ryanjsims/word_clock/PartsList.xlsx

Design | Half | Cost full Total | $61.22 | Cost half Total | $53.21
Ref | Name | Quantity / Grid | Value | Footprint | Description | Vendor | Individual price | Subtotal | Qty Total | Total | URL | Percent of board price full | Percent of board half
J1, J3, | 24 Pin Socket | 2 | Conn_01x24 | Connector_PinSocket_2.54mm:PinSocket_1x24_P2.54mm_Vertical | Generic connector, single row, 01x24, script generated (kicad-library-utils/schlib/autogen/connector/) | Amazon | 0.35 | 0.7 | 2 | 0.7 | https://www.amazon.com/Haobase-2-54mm-Straight-Single-Headers/dp/B01DLX6RSQ/ref=pd_sim_23_1 | 1.143394305% | 1.315561352%
J2, | 5 Pin Header | 1 | Conn_01x05 | Connector_PinHeader_2.54mm:PinHeader_1x05_P2.54mm_Vertical | Generic connector, single row, 01x05, script generated (kicad-library-utils/schlib/autogen/connector/) | Amazon | 0.071125 | 0.071125 | 1 | 0.071125 | https://www.amazon.com/OdiySurveil-2-54mm-Straight-Single-Header/dp/B00UVPT5RI/ref=sr_1_18 | 0.1161770285% | 0.1336704303%
Q1, Q2, Q3, Q4, Q5, Q6, Q7, Q8, Q9, Q10, Q11, Q12, Q13, Q14, Q15, Q16, Q17, Q18, Q19, Q20, Q21, Q22, Q23, Q24, Q25, Q26, Q27, Q28, Q29, Q30, Q31, Q32, Q33, Q34, Q35, Q36, Q37, Q38, Q39, Q40, Q41, Q42, Q43, Q44, Q45, Q46, Q47, Q48, | NPN Low Current | 48 | 2N3904 | Package_TO_SOT_SMD:SOT-23_Handsoldering | 0.2A Ic, 40V Vce, Small Signal NPN Transistor, TO-92 | Digikey | 0.121 | 5.808 | 48 | 5.808 | https://www.digikey.com/product-detail/en/diodes-incorporated/MMBT3904-7-F/MMBT3904-FDICT-ND/815727 | 9.486905889% | 10.91540048%
R1, R4, R7, R10, R13, R16, R19, R22, R25, R28, R31, R34, R37, R40, R43, R46, | 100 Ohm Resistor | 16 | 100 Ohm Resistor | Resistor_THT:R_Axial_DIN0207_L6.3mm_D2.5mm_P10.16mm_Horizontal | Resistor US symbol | Digikey | 0.041 | 0.656 | 16 | 0.656 | https://www.digikey.com/product-detail/en/stackpole-electronics-inc/CF14JT100R/CF14JT100RCT-ND/1830327 | 1.071523806% | 1.232868925%
R2, R3, R5, R6, R8, R9, R11, R12, R14, R15, R17, R18, R20, R21, R23, R24, R26, R27, R29, R30, R32, R33, R35, R36, R38, R39, R41, R42, R44, R45, R47, R48, | 150 Ohm Resistor | 32 | 150 Ohm Resistor | Resistor_THT:R_Axial_DIN0207_L6.3mm_D2.5mm_P10.16mm_Horizontal | Resistor US symbol | Digikey | 0.0288 | 0.9216 | 32 | 0.9216 | https://www.digikey.com/product-detail/en/stackpole-electronics-inc/CF14JT150R/CF14JT150RCT-ND/1830603 | 1.505360273% | 1.732030489%
RN1, RN2, RN3, RN4, RN5, RN6, RN7, RN8, RN9, RN10, RN11, RN12, RN13, RN14, RN15, RN16, RN3 | 3 Resistor Pack | 17 | R_Pack03_SIP_10k | Resistor_THT:R_Array_SIP6 | 3 Resistor network, parallel topology, SIP package | Digikey | 0.328 | 5.576 | 17 | 5.576 | https://www.digikey.com/product-detail/en/bourns-inc/4606X-102-103LF/4606X-2-103LF-ND/1089007 | 9.107952348% | 10.47938586%
U1, U2, U3, U4, U5, U6, U7, U8, U9, U10, U11, U12, U13, U14, U15, U16, | ATTinyX5 | 16 | ATtiny85-20PU | Package_DIP:DIP-8_W7.62mm | 20MHz, 8kB Flash, 512B SRAM, 512B EEPROM, debugWIRE, DIP-8 | Digikey | 1.24 | 19.84 | 16 | 19.84 | https://www.digikey.com/product-detail/en/microchip-technology/ATTINY85-20PU/ATTINY85-20PU-ND/735469 | 32.40706144% | 37.28676747%
D1, D2, D3, D4, D5, D6, D7, D8, D9, D10, D11, D12, D13, D14, D15, D16, D17, D18, D19, D20, D21, D22, D23, D24, D25, D26, D27, D28, D29, D30, D31, D32, D33, D34, D35, D36, D37, D38, D39, D40, D41, D42, D43, D44, D45, D46, D47, D48, D49, D50, D51, D52, D53, D54, D55, D56, D57, D58, D59, D60, D61, D62, D63, D64, D65, D66, D67, D68, D69, D70, D71, D72, D73, D74, D75, D76, D77, D78, D79, D80, D81, D82, D83, D84, D85, D86, D87, D88, D89, D90, D91, D92, D93, D94, D95, D96, D97, D98, D99, D100, D101, D102, D103, D104, D105, D106, D107, D108, D109, D110, D111, D112, D113, D114, D115, D116, D117, D118, D119, D120, D121, D122, D123, D124, D125, D126, D127, D128, D129, D130, D131, D132, D133, D134, D135, D136, D137, D138, D139, D140, D141, D142, D143, D144, D145, D146, D147, D148, D149, D150, D151, D152, D153, D154, D155, D156, D157, D158, D159, D160, D161, D162, D163, D164, D165, D166, D167, D168, D169, D170, D171, D172, D173, D174, D175, D176, | RGB LED | 176 | LED_RGB | LED_SMD:LED_RGB_5050-6 | LED RGB 6 pins | Aliexpress - Slow | 0.0162 | 2.8512 | 200 | 3.24 | https://www.amazon.com/gp/product/B01CUGABPU/ref=oh_aui_detailpage_o03_s00?ie=UTF8&psc=1 | 5.292282211% | 6.089169688%
J1, | 12 Pin Header | 1 | Conn_01x12 | Connector_PinHeader_2.54mm:PinHeader_1x12_P2.54mm_Vertical | Generic connector, single row, 01x12, script generated (kicad-library-utils/schlib/autogen/connector/) | Amazon | 0.1707 | 0.1707 | 1 | 0.1707 | https://www.amazon.com/OdiySurveil-2-54mm-Straight-Single-Header/dp/B00UVPT5RI/ref=sr_1_18 | 0.2788248683% | 0.3208090326%
J3, J2, | 24 Pin Header | 2 | Conn_01x24 | Connector_PinHeader_2.54mm:PinHeader_1x24_P2.54mm_Vertical | Generic connector, single row, 01x24, script generated (kicad-library-utils/schlib/autogen/connector/) | Amazon | 0.3414 | 0.6828 | 2 | 0.6828 | https://www.amazon.com/OdiySurveil-2-54mm-Straight-Single-Header/dp/B00UVPT5RI/ref=sr_1_18 | 1.115299473% | 1.283236131%
Q1, Q7, Q2, Q8, Q3, Q9, Q4, Q10, Q5, Q11, Q6, | NPN Med Current | 11 | DNBT8105 | Package_TO_SOT_SMD:SOT-23_Handsoldering | 60V 1A NPN Transistor | Digikey | 0.309 | 3.399 | 11 | 3.399 | https://www.digikey.com/product-detail/en/diodes-incorporated/DNBT8105-7/DNBT8105DICT-ND/989959 | 5.55199606% | 6.387990052%
RN1, RN2 | 4 Resistor Pack | 2 | R_Pack04_SIP_10k | Resistor_THT:R_Array_SIP8 | 4 Resistor network, parallel topology, SIP package | Digikey | 0.58 | 1.16 | 2 | 1.16 | https://www.digikey.com/product-detail/en/bourns-inc/4608X-102-103LF/4608X-2-103LF-ND/1089107 | 1.894767705% | 2.180073098%
PCB1 | Grid PCB | 1 | PCB | grid.kicad_pcb | Printed Circuit Board | JLCPCB | 1.984 | 1.984 | 1 | 9.984 | https://jlcpcb.com | 16.30806963% | 18.76366363%
PCB2 | Controller PCB | 1 | PCB | controllers.kicad_pcb | Printed Circuit Board | JLCPCB | 1.012 | 1.012 | 1 | 9.012 | https://jlcpcb.com | 14.72038496% | 0%
PCB3 | Half Controller PCB | 2 | PCB | half_controllers.kicad_pcb | Printed Circuit Board | JLCPCB | 0.5 | 1 | 2 | 1 | https://jlcpcb.com | 0% | 1.879373361%
Items | Parts | Cost
Total per Grid | 327 | $44.82
Grids | 1
Total | 351 | $53.21
2N3904 Quantity | Price |  | 100 Ohm Qty | Price |  | DNBT8105 Qty | Price
1 | 0.13 |  | 1 | 0.1 |  | 1 | 0.38
10 | 0.121 |  | 10 | 0.041 |  | 10 | 0.309
100 | 0.0664 |  | 25 | 0.0292 |  | 100 | 0.1667
500 | 0.04152 |  | 50 | 0.0226 |  | 500 | 0.11138
1000 | 0.02884 |  | 100 | 0.0168 |  | 1000 | 0.07738
 |  |  | 250 | 0.01292
 |  |  | 500 | 0.01046
RN 3*10K Ohm Qty | Price |  | 1000 | 0.00784 |  | RN 4*10K Ohm Qty | Price
1 | 0.42 |  |  |  |  | 1 | 0.58
10 | 0.328 |  | 150 Ohm Qty | Price |  | 10 | 0.44
25 | 0.2504 |  | 1 | 0.1 |  | 25 | 0.336
50 | 0.1872 |  | 10 | 0.04 |  | 50 | 0.2508
100 | 0.1401 |  | 25 | 0.0288 |  | 100 | 0.1877
250 | 0.11892 |  | 50 | 0.022 |  | 250 | 0.1594
500 | 0.10246 |  | 100 | 0.0162 |  | 500 | 0.13734
1000 | 0.07896 |  | 250 | 0.01236 |  | 1000 | 0.10584
5000 | 0.06721 |  | 500 | 0.0099 |  | 5000 | 0.09009
 |  |  | 1000 | 0.00729
ATTiny85 Quantity | Price
1 | 1.24 |  | https://www.aliexpress.com/item/100pcs-Ultra-Bright-Red-Green-Blue-SMT-SMD-LED-RGB-5050-LED-DIODE-Chip-Light-Emitting/32340120687.html
25 | 1.1332 |  | Aliexpress RGB LED Qty | Price
100 | 1.03 |  | 100 | 0.0398
 |  |  | 1000 | 0.0239
ATTiny25 Quantity | Price
1 | 1.11 |  | https://www.aliexpress.com/item/100-pcs-5050-RGB-SMD-LED-RED-BLUE-GREEN-SMT-LED-PLCC-6-3-CHIPS-Light/32598851549.html
25 | 1.0196 |  | Aliexpress - Slow RGB LED Qty | Price
100 | 0.9167 |  | 100 | 0.0162
 |  |  | https://www.amazon.com/gp/product/B01CUGABPU/ref=oh_aui_detailpage_o03_s00?ie=UTF8&psc=1
 |  |  | Amazon RGB LED Qty | Price
 |  |  | 100 | 0.0738
