ryanjsims/word_clock/clock_face.dxf

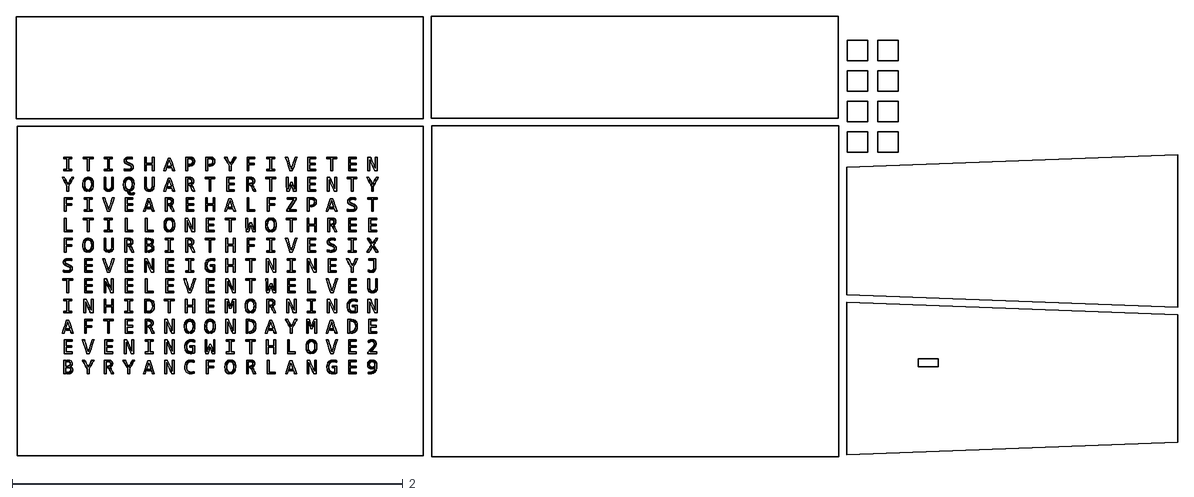
[picture p1: CAD file, 2018-10-16]
clock_face.dxf
5.94 x 2.25
