ryanjsims/word_clock/clock_model.FCStd

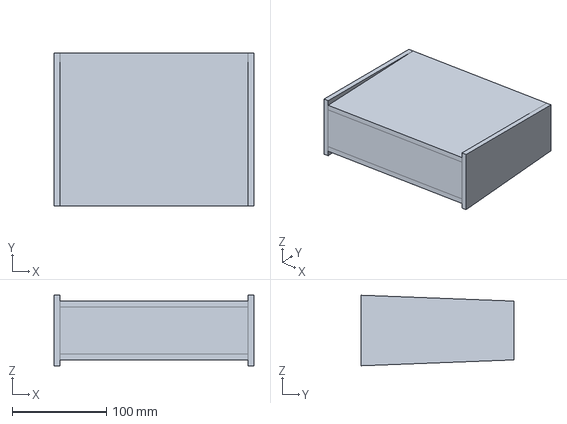
[picture p2: CAD file, 2018-10-16]
clock_model.FCStd
212.5 x 162.5 x 75.0 mm
