ryanjsims/word_clock/(list of files, drawings)

Other design files:
led_grid.fzz
