ryanjsims/word_clock/LED_grid_no_controllers/LED_grid_no_controllers.kicad_pcb

## KiCad design LED_grid_no_controllers/LED_grid_no_controllers.kicad_pcb (2018-12-21)

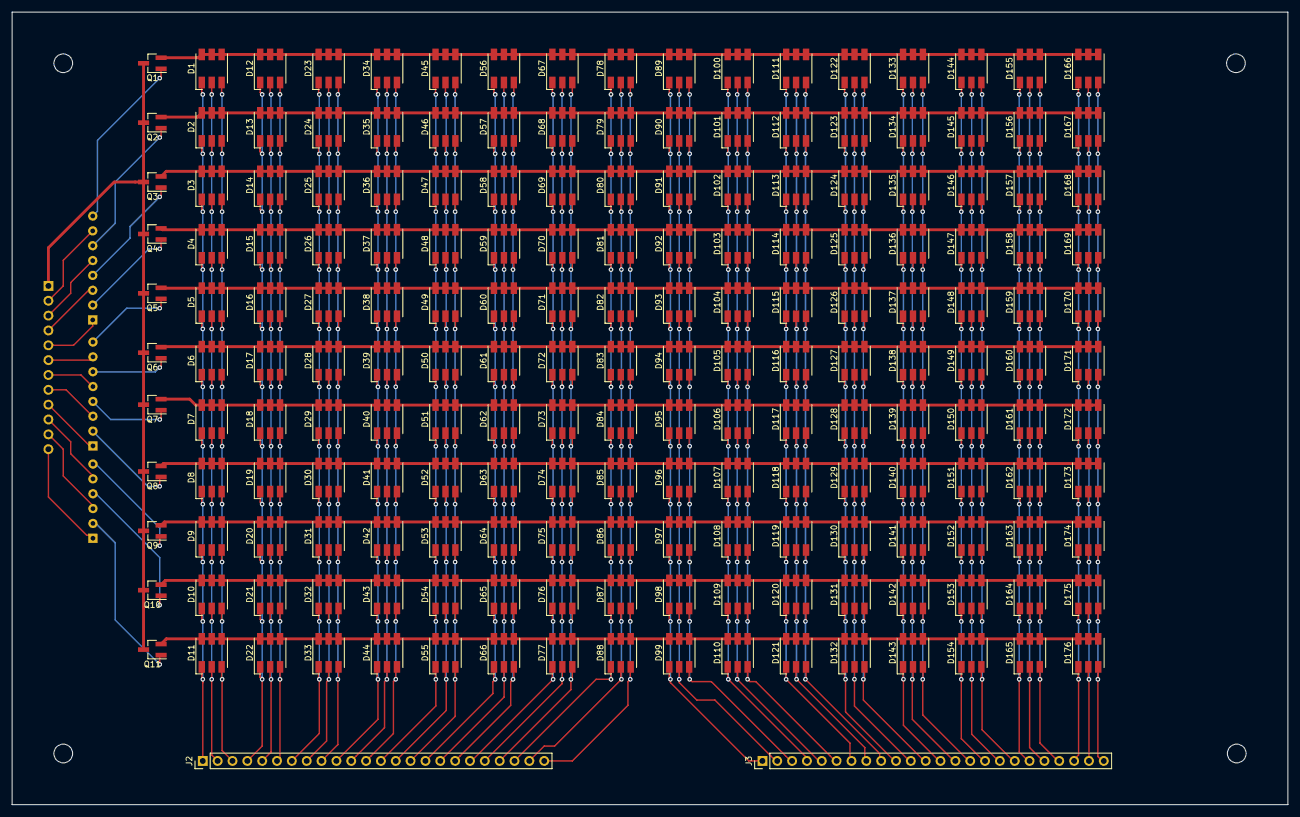
[picture p3: board LED_grid_no_controllers.kicad_pcb from above]

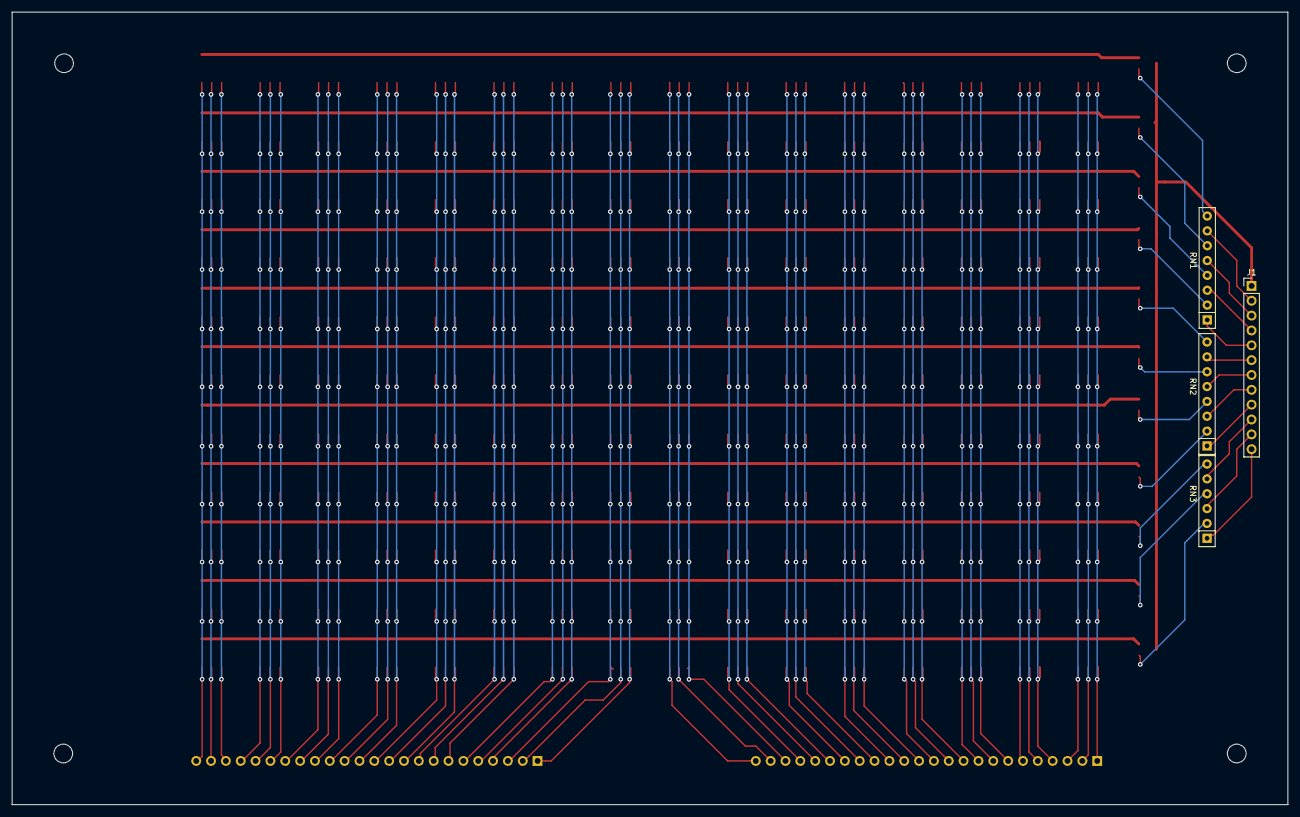
[picture p4: board LED_grid_no_controllers.kicad_pcb from below]

Board: 2 copper layers, 218.3 x 135.6 mm, 193 parts (4 on the bottom side), 82 nets.

Parts:
D1, D2, D3, D4, D5, D6, D7, D8, D9, D10, D11, D12, D13, D14, D15, D16, D17, D18, D19, D20, D21, D22, D23, D24, D25, D26, D27, D28, D29, D30, D31, D32, D33, D34, D35, D36, D37, D38, D39, D40, D41, D42, D43, D44, D45, D46, D47, D48, D49, D50, D51, D52, D53, D54, D55, D56, D57, D58, D59, D60, D61, D62, D63, D64, D65, D66, D67, D68, D69, D70, D71, D72, D73, D74, D75, D76, D77, D78, D79, D80, D81, D82, D83, D84, D85, D86, D87, D88, D89, D90, D91, D92, D93, D94, D95, D96, D97, D98, D99, D100, D101, D102, D103, D104, D105, D106, D107, D108, D109, D110, D111, D112, D113, D114, D115, D116, D117, D118, D119, D120, D121, D122, D123, D124, D125, D126, D127, D128, D129, D130, D131, D132, D133, D134, D135, D136, D137, D138, D139, D140, D141, D142, D143, D144, D145, D146, D147, D148, D149, D150, D151, D152, D153, D154, D155, D156, D157, D158, D159, D160, D161, D162, D163, D164, D165, D166, D167, D168, D169, D170, D171, D172, D173, D174, D175, D176: LED_RGB; LED_RGB_5050-6
J1: Conn_01x12; PinHeader_1x12_P2.54mm_Vertical
J2, J3: Conn_01x24; PinHeader_1x24_P2.54mm_Vertical
Q1, Q2, Q3, Q4, Q5, Q6, Q7, Q8, Q9, Q10, Q11: DNBT8105; SOT-23_Handsoldering
RN1, RN2: R_Pack04_SIP_10k; R_Array_SIP8
RN3: R_Pack03_SIP_10k; R_Array_SIP6

Connections:
+5V: J1.1, Q1.3, Q2.3, Q3.3, Q4.3, Q5.3, Q6.3, Q7.3, Q8.3, Q9.3, Q10.3, Q11.3
/B0: D1.3, D2.3, D3.3, D4.3, D5.3, D6.3, D7.3, D8.3, D9.3, D10.3, D11.3, J2.3
/B1: D12.3, D13.3, D14.3, D15.3, D16.3, D17.3, D18.3, D19.3, D20.3, D21.3, D22.3, J2.6
/B2: D23.3, D24.3, D25.3, D26.3, D27.3, D28.3, D29.3, D30.3, D31.3, D32.3, D33.3, J2.9
/B3: D34.3, D35.3, D36.3, D37.3, D38.3, D39.3, D40.3, D41.3, D42.3, D43.3, D44.3, J2.12
/B4: D45.3, D46.3, D47.3, D48.3, D49.3, D50.3, D51.3, D52.3, D53.3, D54.3, D55.3, J2.15
/B5: D56.3, D57.3, D58.3, D59.3, D60.3, D61.3, D62.3, D63.3, D64.3, D65.3, D66.3, J2.18
/B6: D67.3, D68.3, D69.3, D70.3, D71.3, D72.3, D73.3, D74.3, D75.3, D76.3, D77.3, J2.21
/B7: D78.3, D79.3, D80.3, D81.3, D82.3, D83.3, D84.3, D85.3, D86.3, D87.3, D88.3, J2.24
/B8: D89.3, D90.3, D91.3, D92.3, D93.3, D94.3, D95.3, D96.3, D97.3, D98.3, D99.3, J3.3
/B9: D100.3, D101.3, D102.3, D103.3, D104.3, D105.3, D106.3, D107.3, D108.3, D109.3, D110.3, J3.6
/B10: D111.3, D112.3, D113.3, D114.3, D115.3, D116.3, D117.3, D118.3, D119.3, D120.3, D121.3, J3.9
/B11: D122.3, D123.3, D124.3, D125.3, D126.3, D127.3, D128.3, D129.3, D130.3, D131.3, D132.3, J3.12
/B12: D133.3, D134.3, D135.3, D136.3, D137.3, D138.3, D139.3, D140.3, D141.3, D142.3, D143.3, J3.15
/B13: D144.3, D145.3, D146.3, D147.3, D148.3, D149.3, D150.3, D151.3, D152.3, D153.3, D154.3, J3.18
/B14: D155.3, D156.3, D157.3, D158.3, D159.3, D160.3, D161.3, D162.3, D163.3, D164.3, D165.3, J3.21
/B15: D166.3, D167.3, D168.3, D169.3, D170.3, D171.3, D172.3, D173.3, D174.3, D175.3, D176.3, J3.24
/G0: D1.2, D2.2, D3.2, D4.2, D5.2, D6.2, D7.2, D8.2, D9.2, D10.2, D11.2, J2.2
/G1: D12.2, D13.2, D14.2, D15.2, D16.2, D17.2, D18.2, D19.2, D20.2, D21.2, D22.2, J2.5
/G2: D23.2, D24.2, D25.2, D26.2, D27.2, D28.2, D29.2, D30.2, D31.2, D32.2, D33.2, J2.8
/G3: D34.2, D35.2, D36.2, D37.2, D38.2, D39.2, D40.2, D41.2, D42.2, D43.2, D44.2, J2.11
/G4: D45.2, D46.2, D47.2, D48.2, D49.2, D50.2, D51.2, D52.2, D53.2, D54.2, D55.2, J2.14
/G5: D56.2, D57.2, D58.2, D59.2, D60.2, D61.2, D62.2, D63.2, D64.2, D65.2, D66.2, J2.17
/G6: D67.2, D68.2, D69.2, D70.2, D71.2, D72.2, D73.2, D74.2, D75.2, D76.2, D77.2, J2.20
/G7: D78.2, D79.2, D80.2, D81.2, D82.2, D83.2, D84.2, D85.2, D86.2, D87.2, D88.2, J2.23
/G8: D89.2, D90.2, D91.2, D92.2, D93.2, D94.2, D95.2, D96.2, D97.2, D98.2, D99.2, J3.2
/G9: D100.2, D101.2, D102.2, D103.2, D104.2, D105.2, D106.2, D107.2, D108.2, D109.2, D110.2, J3.5
/G10: D111.2, D112.2, D113.2, D114.2, D115.2, D116.2, D117.2, D118.2, D119.2, D120.2, D121.2, J3.8
/G11: D122.2, D123.2, D124.2, D125.2, D126.2, D127.2, D128.2, D129.2, D130.2, D131.2, D132.2, J3.11
/G12: D133.2, D134.2, D135.2, D136.2, D137.2, D138.2, D139.2, D140.2, D141.2, D142.2, D143.2, J3.14
/G13: D144.2, D145.2, D146.2, D147.2, D148.2, D149.2, D150.2, D151.2, D152.2, D153.2, D154.2, J3.17
/G14: D155.2, D156.2, D157.2, D158.2, D159.2, D160.2, D161.2, D162.2, D163.2, D164.2, D165.2, J3.20
/G15: D166.2, D167.2, D168.2, D169.2, D170.2, D171.2, D172.2, D173.2, D174.2, D175.2, D176.2, J3.23
/R0: D1.1, D2.1, D3.1, D4.1, D5.1, D6.1, D7.1, D8.1, D9.1, D10.1, D11.1, J2.1
/R1: D12.1, D13.1, D14.1, D15.1, D16.1, D17.1, D18.1, D19.1, D20.1, D21.1, D22.1, J2.4
/R2: D23.1, D24.1, D25.1, D26.1, D27.1, D28.1, D29.1, D30.1, D31.1, D32.1, D33.1, J2.7
/R3: D34.1, D35.1, D36.1, D37.1, D38.1, D39.1, D40.1, D41.1, D42.1, D43.1, D44.1, J2.10
/R4: D45.1, D46.1, D47.1, D48.1, D49.1, D50.1, D51.1, D52.1, D53.1, D54.1, D55.1, J2.13
/R5: D56.1, D57.1, D58.1, D59.1, D60.1, D61.1, D62.1, D63.1, D64.1, D65.1, D66.1, J2.16
/R6: D67.1, D68.1, D69.1, D70.1, D71.1, D72.1, D73.1, D74.1, D75.1, D76.1, D77.1, J2.19
/R7: D78.1, D79.1, D80.1, D81.1, D82.1, D83.1, D84.1, D85.1, D86.1, D87.1, D88.1, J2.22
/R8: D89.1, D90.1, D91.1, D92.1, D93.1, D94.1, D95.1, D96.1, D97.1, D98.1, D99.1, J3.1
/R9: D100.1, D101.1, D102.1, D103.1, D104.1, D105.1, D106.1, D107.1, D108.1, D109.1, D110.1, J3.4
/R10: D111.1, D112.1, D113.1, D114.1, D115.1, D116.1, D117.1, D118.1, D119.1, D120.1, D121.1, J3.7
/R11: D122.1, D123.1, D124.1, D125.1, D126.1, D127.1, D128.1, D129.1, D130.1, D131.1, D132.1, J3.10
/R12: D133.1, D134.1, D135.1, D136.1, D137.1, D138.1, D139.1, D140.1, D141.1, D142.1, D143.1, J3.13
/R13: D144.1, D145.1, D146.1, D147.1, D148.1, D149.1, D150.1, D151.1, D152.1, D153.1, D154.1, J3.16
/R14: D155.1, D156.1, D157.1, D158.1, D159.1, D160.1, D161.1, D162.1, D163.1, D164.1, D165.1, J3.19
/R15: D166.1, D167.1, D168.1, D169.1, D170.1, D171.1, D172.1, D173.1, D174.1, D175.1, D176.1, J3.22
/ROW0: D1.4, D1.5, D1.6, D12.4, D12.5, D12.6, D23.4, D23.5, D23.6, D34.4, D34.5, D34.6, D45.4, D45.5, D45.6, D56.4, D56.5, D56.6, D67.4, D67.5, D67.6, D78.4, D78.5, D78.6, D89.4, D89.5, D89.6, D100.4, D100.5, D100.6, D111.4, D111.5, D111.6, D122.4, D122.5, D122.6, D133.4, D133.5, D133.6, D144.4, D144.5, D144.6, D155.4, D155.5, D155.6, D166.4, D166.5, D166.6, Q1.2
/ROW1: D2.4, D2.5, D2.6, D13.4, D13.5, D13.6, D24.4, D24.5, D24.6, D35.4, D35.5, D35.6, D46.4, D46.5, D46.6, D57.4, D57.5, D57.6, D68.4, D68.5, D68.6, D79.4, D79.5, D79.6, D90.4, D90.5, D90.6, D101.4, D101.5, D101.6, D112.4, D112.5, D112.6, D123.4, D123.5, D123.6, D134.4, D134.5, D134.6, D145.4, D145.5, D145.6, D156.4, D156.5, D156.6, D167.4, D167.5, D167.6, Q2.2
/ROW2: D3.4, D3.5, D3.6, D14.4, D14.5, D14.6, D25.4, D25.5, D25.6, D36.4, D36.5, D36.6, D47.4, D47.5, D47.6, D58.4, D58.5, D58.6, D69.4, D69.5, D69.6, D80.4, D80.5, D80.6, D91.4, D91.5, D91.6, D102.4, D102.5, D102.6, D113.4, D113.5, D113.6, D124.4, D124.5, D124.6, D135.4, D135.5, D135.6, D146.4, D146.5, D146.6, D157.4, D157.5, D157.6, D168.4, D168.5, D168.6, Q3.2
/ROW3: D4.4, D4.5, D4.6, D15.4, D15.5, D15.6, D26.4, D26.5, D26.6, D37.4, D37.5, D37.6, D48.4, D48.5, D48.6, D59.4, D59.5, D59.6, D70.4, D70.5, D70.6, D81.4, D81.5, D81.6, D92.4, D92.5, D92.6, D103.4, D103.5, D103.6, D114.4, D114.5, D114.6, D125.4, D125.5, D125.6, D136.4, D136.5, D136.6, D147.4, D147.5, D147.6, D158.4, D158.5, D158.6, D169.4, D169.5, D169.6, Q4.2
/ROW4: D5.4, D5.5, D5.6, D16.4, D16.5, D16.6, D27.4, D27.5, D27.6, D38.4, D38.5, D38.6, D49.4, D49.5, D49.6, D60.4, D60.5, D60.6, D71.4, D71.5, D71.6, D82.4, D82.5, D82.6, D93.4, D93.5, D93.6, D104.4, D104.5, D104.6, D115.4, D115.5, D115.6, D126.4, D126.5, D126.6, D137.4, D137.5, D137.6, D148.4, D148.5, D148.6, D159.4, D159.5, D159.6, D170.4, D170.5, D170.6, Q5.2
/ROW5: D6.4, D6.5, D6.6, D17.4, D17.5, D17.6, D28.4, D28.5, D28.6, D39.4, D39.5, D39.6, D50.4, D50.5, D50.6, D61.4, D61.5, D61.6, D72.4, D72.5, D72.6, D83.4, D83.5, D83.6, D94.4, D94.5, D94.6, D105.4, D105.5, D105.6, D116.4, D116.5, D116.6, D127.4, D127.5, D127.6, D138.4, D138.5, D138.6, D149.4, D149.5, D149.6, D160.4, D160.5, D160.6, D171.4, D171.5, D171.6, Q6.2
/ROW6: D7.4, D7.5, D7.6, D18.4, D18.5, D18.6, D29.4, D29.5, D29.6, D40.4, D40.5, D40.6, D51.4, D51.5, D51.6, D62.4, D62.5, D62.6, D73.4, D73.5, D73.6, D84.4, D84.5, D84.6, D95.4, D95.5, D95.6, D106.4, D106.5, D106.6, D117.4, D117.5, D117.6, D128.4, D128.5, D128.6, D139.4, D139.5, D139.6, D150.4, D150.5, D150.6, D161.4, D161.5, D161.6, D172.4, D172.5, D172.6, Q7.2
/ROW7: D8.4, D8.5, D8.6, D19.4, D19.5, D19.6, D30.4, D30.5, D30.6, D41.4, D41.5, D41.6, D52.4, D52.5, D52.6, D63.4, D63.5, D63.6, D74.4, D74.5, D74.6, D85.4, D85.5, D85.6, D96.4, D96.5, D96.6, D107.4, D107.5, D107.6, D118.4, D118.5, D118.6, D129.4, D129.5, D129.6, D140.4, D140.5, D140.6, D151.4, D151.5, D151.6, D162.4, D162.5, D162.6, D173.4, D173.5, D173.6, Q8.2
/ROW8: D9.4, D9.5, D9.6, D20.4, D20.5, D20.6, D31.4, D31.5, D31.6, D42.4, D42.5, D42.6, D53.4, D53.5, D53.6, D64.4, D64.5, D64.6, D75.4, D75.5, D75.6, D86.4, D86.5, D86.6, D97.4, D97.5, D97.6, D108.4, D108.5, D108.6, D119.4, D119.5, D119.6, D130.4, D130.5, D130.6, D141.4, D141.5, D141.6, D152.4, D152.5, D152.6, D163.4, D163.5, D163.6, D174.4, D174.5, D174.6, Q9.2
/ROW9: D10.4, D10.5, D10.6, D21.4, D21.5, D21.6, D32.4, D32.5, D32.6, D43.4, D43.5, D43.6, D54.4, D54.5, D54.6, D65.4, D65.5, D65.6, D76.4, D76.5, D76.6, D87.4, D87.5, D87.6, D98.4, D98.5, D98.6, D109.4, D109.5, D109.6, D120.4, D120.5, D120.6, D131.4, D131.5, D131.6, D142.4, D142.5, D142.6, D153.4, D153.5, D153.6, D164.4, D164.5, D164.6, D175.4, D175.5, D175.6, Q10.2
/ROW10: D11.4, D11.5, D11.6, D22.4, D22.5, D22.6, D33.4, D33.5, D33.6, D44.4, D44.5, D44.6, D55.4, D55.5, D55.6, D66.4, D66.5, D66.6, D77.4, D77.5, D77.6, D88.4, D88.5, D88.6, D99.4, D99.5, D99.6, D110.4, D110.5, D110.6, D121.4, D121.5, D121.6, D132.4, D132.5, D132.6, D143.4, D143.5, D143.6, D154.4, D154.5, D154.6, D165.4, D165.5, D165.6, D176.4, D176.5, D176.6, Q11.2
/ROW_IN_0: J1.2, RN1.7
/ROW_IN_1: J1.3, RN1.5
/ROW_IN_2: J1.4, RN1.3
/ROW_IN_3: J1.5, RN1.1
/ROW_IN_4: J1.6, RN2.7
/ROW_IN_5: J1.7, RN2.5
/ROW_IN_6: J1.8, RN2.3
/ROW_IN_7: J1.9, RN2.1
/ROW_IN_8: J1.10, RN3.5
/ROW_IN_9: J1.11, RN3.3
/ROW_IN_10: J1.12, RN3.1
/ROW_SEL_0: Q1.1, RN1.8
/ROW_SEL_1: Q2.1, RN1.6
/ROW_SEL_2: Q3.1, RN1.4
/ROW_SEL_3: Q4.1, RN1.2
/ROW_SEL_4: Q5.1, RN2.8
/ROW_SEL_5: Q6.1, RN2.6
/ROW_SEL_6: Q7.1, RN2.4
/ROW_SEL_7: Q8.1, RN2.2
/ROW_SEL_8: Q9.1, RN3.6
/ROW_SEL_9: Q10.1, RN3.4
/ROW_SEL_10: Q11.1, RN3.2
