ryanjsims/word_clock/LED_grid_controllers/LED_grid_half_controllers.kicad_pcb

## KiCad design LED_grid_controllers/LED_grid_half_controllers.kicad_pcb (2018-12-21)

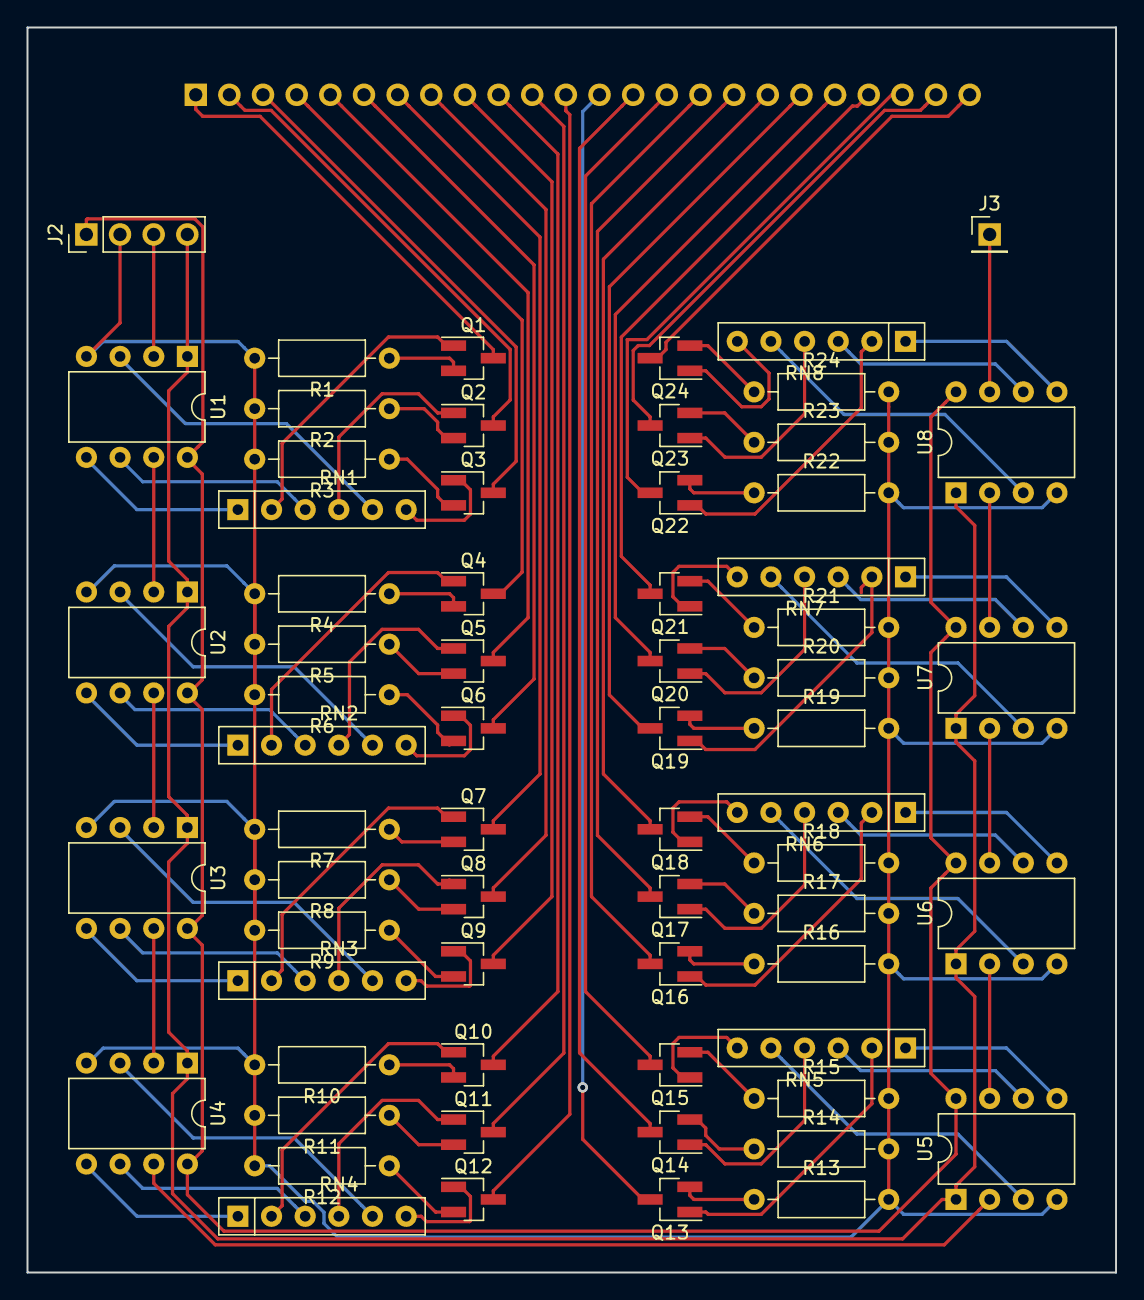
[picture p5: board LED_grid_half_controllers.kicad_pcb from above]

Board: 2 copper layers, 82.2 x 94.0 mm, 67 parts (1 on the bottom side), 108 nets.

Parts:
J1: Conn_01x24; PinSocket_1x24_P2.54mm_Vertical
J2: Conn_01x04; PinHeader_1x04_P2.54mm_Vertical
J3: Conn_01x01; PinHeader_1x01_P2.54mm_Vertical
Q1, Q2, Q3, Q4, Q5, Q6, Q7, Q8, Q9, Q10, Q11, Q12, Q13, Q14, Q15, Q16, Q17, Q18, Q19, Q20, Q21, Q22, Q23, Q24: 2N3904_SOT-23; SOT-23_Handsoldering
R1, R4, R7, R10, R13, R16, R19, R22: 100; R_Axial_DIN0207_L6.3mm_D2.5mm_P10.16mm_Horizontal
R2, R3, R5, R6, R8, R9, R11, R12, R14, R15, R17, R18, R20, R21, R23, R24: 150; R_Axial_DIN0207_L6.3mm_D2.5mm_P10.16mm_Horizontal
RN1, RN2, RN3, RN4, RN5, RN6, RN7, RN8: R_Pack03_SIP_10k; R_Array_SIP6
U1, U2, U3, U4, U5, U6, U7, U8: ATtiny85-20PU; DIP-8_W7.62mm

Connections:
+5V: J2.1, U1.8, U2.8, U3.8, U4.8, U5.8, U6.8, U7.8, U8.8
/B0: J1.3, Q3.3
/B1: J1.6, Q6.3
/B2: J1.9, Q9.3
/B3: J1.12, Q12.3
/B4: J1.15, Q15.3
/B5: J1.18, Q18.3
/B6: J1.21, Q21.3
/B7: J1.24, Q24.3
/Controller0/B_PWM: RN1.5, U1.3
/Controller0/B_RES_OUT: Q3.1, RN1.6
/Controller0/G_PWM: RN1.3, U1.6
/Controller0/G_RES_OUT: Q2.1, RN1.4
/Controller0/R_PWM: RN1.1, U1.5
/Controller0/R_RES_OUT: Q1.1, RN1.2
/Controller1/B_PWM: RN2.5, U2.3
/Controller1/B_RES_OUT: Q6.1, RN2.6
/Controller1/DIN: U1.7, U2.2
/Controller1/G_PWM: RN2.3, U2.6
/Controller1/G_RES_OUT: Q5.1, RN2.4
/Controller1/R_PWM: RN2.1, U2.5
/Controller1/R_RES_OUT: Q4.1, RN2.2
/Controller2/B_PWM: RN3.5, U3.3
/Controller2/B_RES_OUT: Q9.1, RN3.6
/Controller2/DIN: U2.7, U3.2
/Controller2/G_PWM: RN3.3, U3.6
/Controller2/G_RES_OUT: Q8.1, RN3.4
/Controller2/R_PWM: RN3.1, U3.5
/Controller2/R_RES_OUT: Q7.1, RN3.2
/Controller3/B_PWM: RN4.5, U4.3
/Controller3/B_RES_OUT: Q12.1, RN4.6
/Controller3/DIN: U3.7, U4.2
/Controller3/G_PWM: RN4.3, U4.6
/Controller3/G_RES_OUT: Q11.1, RN4.4
/Controller3/R_PWM: RN4.1, U4.5
/Controller3/R_RES_OUT: Q10.1, RN4.2
/Controller4/B_PWM: RN5.5, U5.3
/Controller4/B_RES_OUT: Q15.1, RN5.6
/Controller4/G_PWM: RN5.3, U5.6
/Controller4/G_RES_OUT: Q14.1, RN5.4
/Controller4/R_PWM: RN5.1, U5.5
/Controller4/R_RES_OUT: Q13.1, RN5.2
/Controller5/B_PWM: RN6.5, U6.3
/Controller5/B_RES_OUT: Q18.1, RN6.6
/Controller5/DIN: U5.7, U6.2
/Controller5/G_PWM: RN6.3, U6.6
/Controller5/G_RES_OUT: Q17.1, RN6.4
/Controller5/R_PWM: RN6.1, U6.5
/Controller5/R_RES_OUT: Q16.1, RN6.2
/Controller6/B_PWM: RN7.5, U7.3
/Controller6/B_RES_OUT: Q21.1, RN7.6
/Controller6/DIN: U6.7, U7.2
/Controller6/G_PWM: RN7.3, U7.6
/Controller6/G_RES_OUT: Q20.1, RN7.4
/Controller6/R_PWM: RN7.1, U7.5
/Controller6/R_RES_OUT: Q19.1, RN7.2
/Controller7/B_PWM: RN8.5, U8.3
/Controller7/B_RES_OUT: Q24.1, RN8.6
/Controller7/DIN: U7.7, U8.2
/Controller7/G_PWM: RN8.3, U8.6
/Controller7/G_RES_OUT: Q23.1, RN8.4
/Controller7/R_PWM: RN8.1, U8.5
/Controller7/R_RES_OUT: Q22.1, RN8.2
/DCLK: J2.4, U1.1, U2.1, U3.1, U4.1, U5.1, U6.1, U7.1, U8.1
/DIN: J2.3, U1.2
/DOUT: J3.1, U8.7
/DOUT3: U4.7, U5.2
/G0: J1.2, Q2.3
/G1: J1.5, Q5.3
/G2: J1.8, Q8.3
/G3: J1.11, Q11.3
/G4: J1.14, Q14.3
/G5: J1.17, Q17.3
/G6: J1.20, Q20.3
/G7: J1.23, Q23.3
/R0: J1.1, Q1.3
/R1: J1.4, Q4.3
/R2: J1.7, Q7.3
/R3: J1.10, Q10.3
/R4: J1.13, Q13.3
/R5: J1.16, Q16.3
/R6: J1.19, Q19.3
/R7: J1.22, Q22.3
GND: J2.2, R1.2, R2.2, R3.2, R4.2, R5.2, R6.2, R7.2, R8.2, R9.2, R10.2, R11.2, R12.2, R13.2, R14.2, R15.2, R16.2, R17.2, R18.2, R19.2, R20.2, R21.2, R22.2, R23.2, R24.2, U1.4, U2.4, U3.4, U4.4, U5.4, U6.4, U7.4, U8.4
unnamed: Q1.2, R1.1
unnamed: Q2.2, R2.1
unnamed: Q3.2, R3.1
unnamed: Q4.2, R4.1
unnamed: Q5.2, R5.1
unnamed: Q6.2, R6.1
unnamed: Q7.2, R7.1
unnamed: Q8.2, R8.1
unnamed: Q9.2, R9.1
unnamed: Q10.2, R10.1
unnamed: Q11.2, R11.1
unnamed: Q12.2, R12.1
unnamed: Q13.2, R13.1
unnamed: Q14.2, R14.1
unnamed: Q15.2, R15.1
unnamed: Q16.2, R16.1
unnamed: Q17.2, R17.1
unnamed: Q18.2, R18.1
unnamed: Q19.2, R19.1
unnamed: Q20.2, R20.1
unnamed: Q21.2, R21.1
unnamed: Q22.2, R22.1
unnamed: Q23.2, R23.1
unnamed: Q24.2, R24.1
