ryanjsims/word_clock/LED_grid_controllers/LED_grid_TLC5946/LED_grid_TLC5946.kicad_pcb

## KiCad design LED_grid_controllers/LED_grid_TLC5946/LED_grid_TLC5946.kicad_pcb (2018-12-21)

Schematic: LED_grid_TLC5946.sch

Parts:
C1, C2: 10pF; C_0805_2012Metric_Pad1.15x1.40mm_HandSolder
C3, C4, C5: 0.1uF; C_1206_3216Metric_Pad1.42x1.75mm_HandSolder
J1, J3: Conn_01x24; PinHeader_1x24_P2.54mm_Vertical
J2: Conn_01x10; PinHeader_1x10_P2.54mm_Vertical
R1, R2, R3: 3.3k; R_1206_3216Metric_Pad1.42x1.75mm_HandSolder
R4: >1MΩ; R_1206_3216Metric_Pad1.42x1.75mm_HandSolder
R5: 270Ω; R_1206_3216Metric_Pad1.42x1.75mm_HandSolder
U1, U2, U5: TLC5946PW; TSSOP-28_4.4x9.7mm_P0.65mm
U3: 74LVC1G08DBVR; SOT-23-5_HandSoldering
U4: 74LVC2G14DBVR; SOT-23-6_Handsoldering
Y1: 20MHz Crystal; Crystal_SMD_HC49-SD_HandSoldering

Connections:
/B0: J1.3, U1.9
/B1: J1.6, U1.12
/B2: J1.16, U1.15
/B3: J1.13, U1.18
/B4: J1.10, U1.21
/B5: J1.18, U2.8
/B6: J1.21, U2.11
/B7: J1.24, U2.14
/B8: J3.3, U2.17
/B9: J3.6, U2.20
/B10: J3.16, U5.7
/B11: J3.13, U5.10
/B12: J3.10, U5.13
/B13: J3.18, U5.16
/B14: J3.21, U5.19
/B15: J3.24, U5.22
/BLANK: J2.3, U1.2, U2.2, U5.2
/G0: J1.2, U1.8
/G1: J1.5, U1.11
/G2: J1.8, U1.14
/G3: J1.14, U1.17
/G4: J1.11, U1.20
/G5: J1.17, U2.7
/G6: J1.20, U2.10
/G7: J1.23, U2.13
/G8: J3.2, U2.16
/G9: J3.5, U2.19
/G10: J3.8, U2.22
/G11: J3.14, U5.9
/G12: J3.11, U5.12
/G13: J3.17, U5.15
/G14: J3.20, U5.18
/G15: J3.23, U5.21
/GSCLK: U1.25, U2.25, U3.4, U5.25
/GSCLK_EN: J2.8, U3.1
/MODE: J2.7, U1.6, U2.6, U5.6
/R0: J1.1, U1.7
/R1: J1.4, U1.10
/R2: J1.7, U1.13
/R3: J1.15, U1.16
/R4: J1.12, U1.19
/R5: J1.9, U1.22
/R6: J1.19, U2.9
/R7: J1.22, U2.12
/R8: J3.1, U2.15
/R9: J3.4, U2.18
/R10: J3.7, U2.21
/R11: J3.15, U5.8
/R12: J3.12, U5.11
/R13: J3.9, U5.14
/R14: J3.19, U5.17
/R15: J3.22, U5.20
/SCLK: J2.5, U1.4, U2.4, U5.4
/SIN: J2.6, U1.5
/SOUT0: U1.24, U2.5
/SOUT1: U2.24, U5.5
/SOUT2: J2.10, U5.24
/XERR: J2.9, U1.23, U2.23, U5.23
/XLAT: J2.4, U1.3, U2.3, U5.3
GND: C1.2, C2.2, C3.2, C4.2, C5.2, J2.2, R1.2, R2.2, R3.2, U1.1, U2.1, U3.3 (GND), U4.2, U5.1
unnamed: C1.1, R4.2, U4.1, Y1.1
unnamed: C2.1, R5.2, Y1.2
unnamed: R1.1, U1.27
unnamed: R2.1, U2.27
unnamed: R3.1, U5.27
unnamed: R4.1, R5.1, U4.3, U4.6
unnamed: U3.2, U4.4
VCC: C3.1, C4.1, C5.1, J2.1, U1.26, U1.28, U2.26, U2.28, U3.5 (VCC), U4.5, U5.26, U5.28

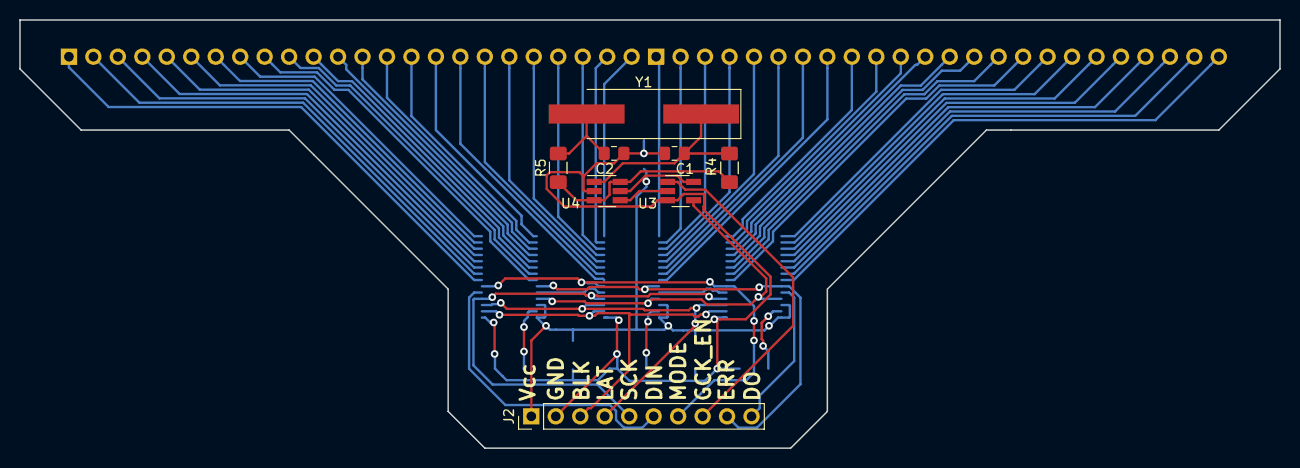
[picture p6: board LED_grid_TLC5946.kicad_pcb from above]

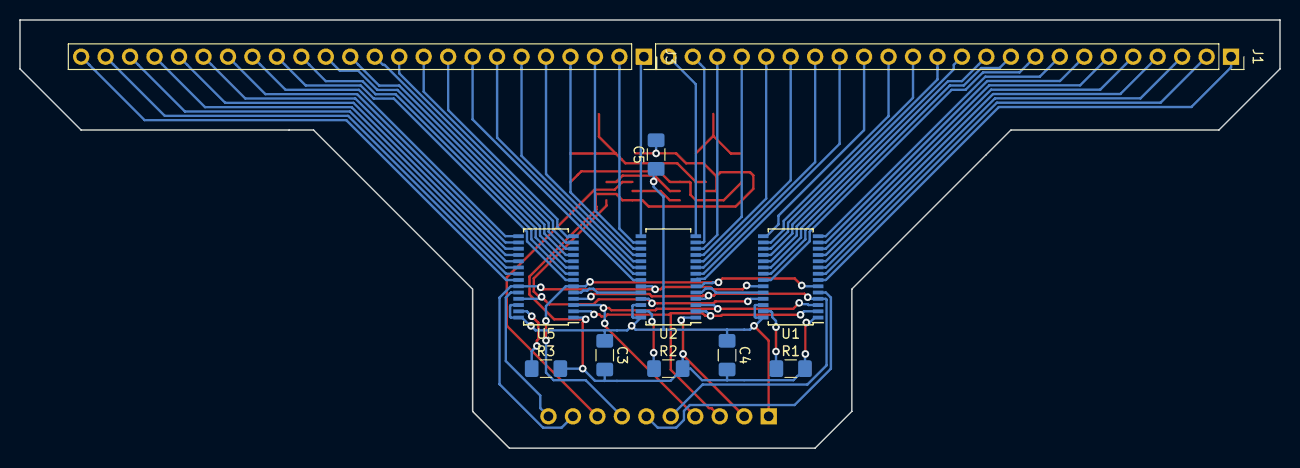
[picture p7: board LED_grid_TLC5946.kicad_pcb from below]

Board: 2 copper layers, 130.8 x 44.4 mm, 19 parts (11 on the bottom side), 68 nets.
