ryanjsims/word_clock/LED_grid/LED_grid.kicad_pcb

## KiCad design LED_grid/LED_grid.kicad_pcb (2018-12-05)

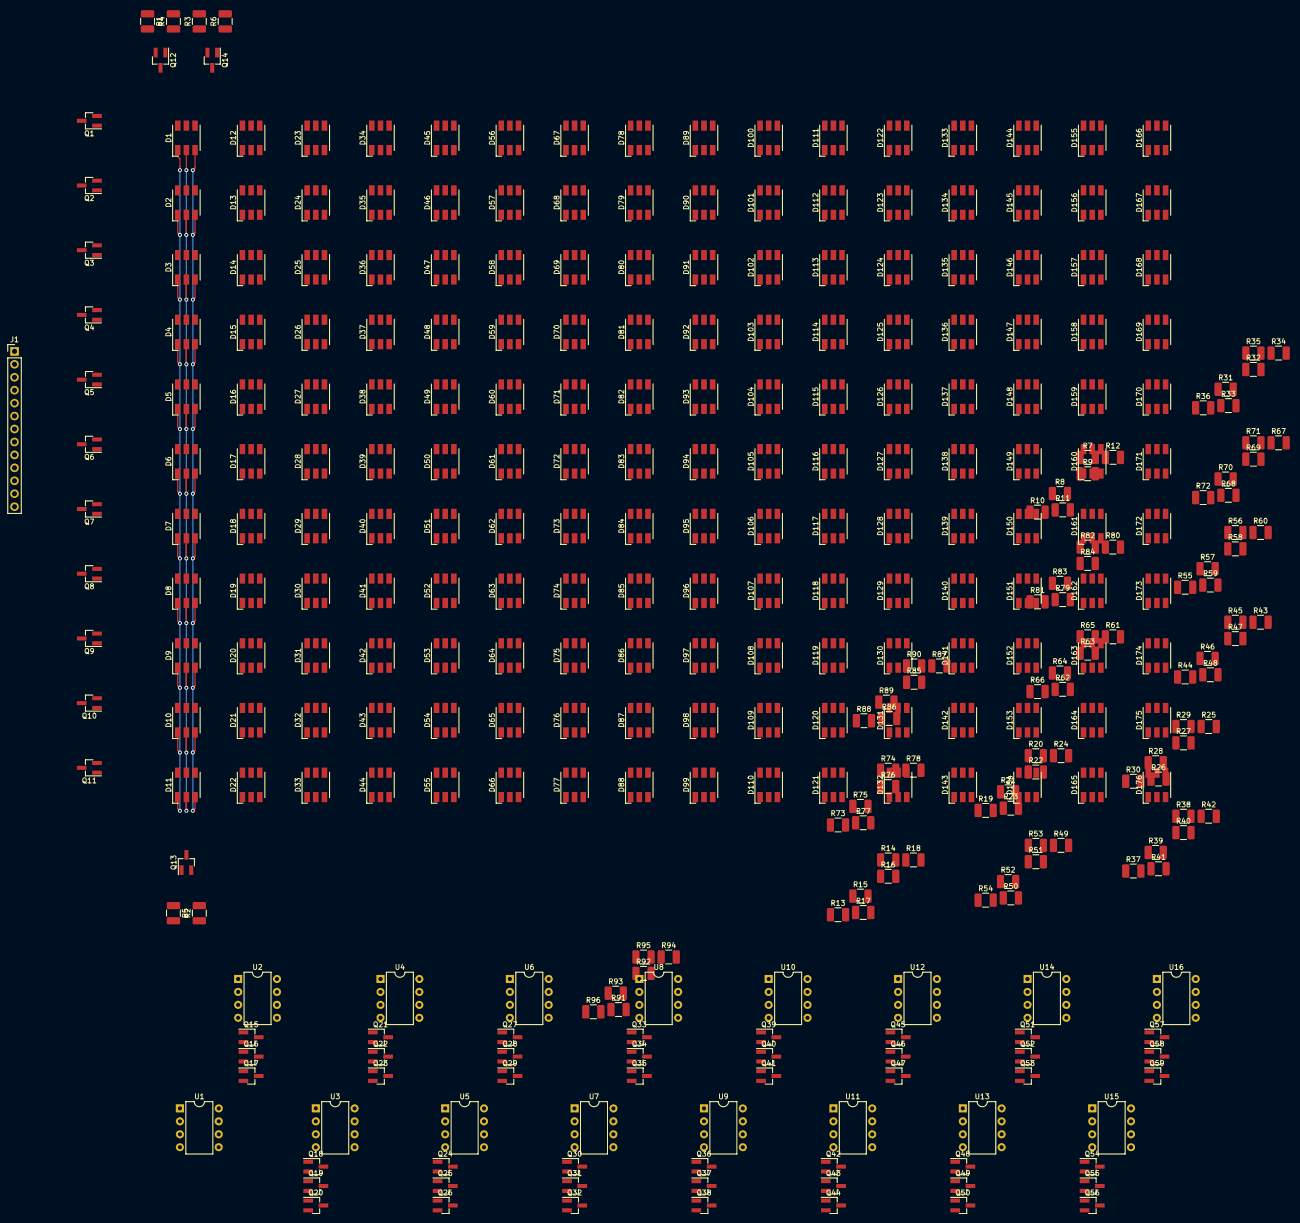
[picture p8: board LED_grid.kicad_pcb from above]

Board: 2 copper layers, 348 parts (0 on the bottom side), 233 nets.

Parts:
D1, D2, D3, D4, D5, D6, D7, D8, D9, D10, D11, D12, D13, D14, D15, D16, D17, D18, D19, D20, D21, D22, D23, D24, D25, D26, D27, D28, D29, D30, D31, D32, D33, D34, D35, D36, D37, D38, D39, D40, D41, D42, D43, D44, D45, D46, D47, D48, D49, D50, D51, D52, D53, D54, D55, D56, D57, D58, D59, D60, D61, D62, D63, D64, D65, D66, D67, D68, D69, D70, D71, D72, D73, D74, D75, D76, D77, D78, D79, D80, D81, D82, D83, D84, D85, D86, D87, D88, D89, D90, D91, D92, D93, D94, D95, D96, D97, D98, D99, D100, D101, D102, D103, D104, D105, D106, D107, D108, D109, D110, D111, D112, D113, D114, D115, D116, D117, D118, D119, D120, D121, D122, D123, D124, D125, D126, D127, D128, D129, D130, D131, D132, D133, D134, D135, D136, D137, D138, D139, D140, D141, D142, D143, D144, D145, D146, D147, D148, D149, D150, D151, D152, D153, D154, D155, D156, D157, D158, D159, D160, D161, D162, D163, D164, D165, D166, D167, D168, D169, D170, D171, D172, D173, D174, D175, D176: LED_RGB; LED_RGB_5050-6
J1: Conn_01x13; PinHeader_1x13_P2.54mm_Vertical
Q1, Q2, Q3, Q4, Q5, Q6, Q7, Q8, Q9, Q10, Q11: FMMT620CT-ND; SOT-23_Handsoldering
Q12, Q13, Q14, Q15, Q16, Q17, Q18, Q19, Q20, Q21, Q22, Q23, Q24, Q25, Q26, Q27, Q28, Q29, Q30, Q31, Q32, Q33, Q34, Q35, Q36, Q37, Q38, Q39, Q40, Q41, Q42, Q43, Q44, Q45, Q46, Q47, Q48, Q49, Q50, Q51, Q52, Q53, Q54, Q55, Q56, Q57, Q58, Q59: 2N3904; SOT-23_Handsoldering
R1, R2, R3, R7, R8, R9, R13, R14, R15, R19, R20, R21, R25, R26, R27, R31, R32, R33, R37, R38, R39, R43, R44, R45, R49, R50, R51, R55, R56, R57, R61, R62, R63, R67, R68, R69, R73, R74, R75, R79, R80, R81, R85, R86, R87, R91, R92, R93: 10k; R_1210_3225Metric_Pad1.42x2.65mm_HandSolder
R4, R10, R16, R22, R28, R34, R40, R46, R52, R58, R64, R70, R76, R82, R88, R94: 100; R_1210_3225Metric_Pad1.42x2.65mm_HandSolder
R5, R6, R11, R12, R17, R18, R23, R24, R29, R30, R35, R36, R41, R42, R47, R48, R53, R54, R59, R60, R65, R66, R71, R72, R77, R78, R83, R84, R89, R90, R95, R96: 150; R_1210_3225Metric_Pad1.42x2.65mm_HandSolder
U1, U2, U3, U4, U5, U6, U7, U8, U9, U10, U11, U12, U13, U14, U15, U16: ATtiny85-20PU; DIP-8_W7.62mm

Connections:
+5V: Q1.2, Q2.2, Q3.2, Q4.2, Q5.2, Q6.2, Q7.2, Q8.2, Q9.2, Q10.2, Q11.2, U1.8, U2.8, U3.8, U4.8, U5.8, U6.8, U7.8, U8.8, U9.8, U10.8, U11.8, U12.8, U13.8, U14.8, U15.8, U16.8
/0: D1.4, D1.5, D1.6, D12.4, D12.5, D12.6, D23.4, D23.5, D23.6, D34.4, D34.5, D34.6, D45.4, D45.5, D45.6, D56.4, D56.5, D56.6, D67.4, D67.5, D67.6, D78.4, D78.5, D78.6, D89.4, D89.5, D89.6, D100.4, D100.5, D100.6, D111.4, D111.5, D111.6, D122.4, D122.5, D122.6, D133.4, D133.5, D133.6, D144.4, D144.5, D144.6, D155.4, D155.5, D155.6, D166.4, D166.5, D166.6, Q1.1
/1: D2.4, D2.5, D2.6, D13.4, D13.5, D13.6, D24.4, D24.5, D24.6, D35.4, D35.5, D35.6, D46.4, D46.5, D46.6, D57.4, D57.5, D57.6, D68.4, D68.5, D68.6, D79.4, D79.5, D79.6, D90.4, D90.5, D90.6, D101.4, D101.5, D101.6, D112.4, D112.5, D112.6, D123.4, D123.5, D123.6, D134.4, D134.5, D134.6, D145.4, D145.5, D145.6, D156.4, D156.5, D156.6, D167.4, D167.5, D167.6, Q2.1
/2: D3.4, D3.5, D3.6, D14.4, D14.5, D14.6, D25.4, D25.5, D25.6, D36.4, D36.5, D36.6, D47.4, D47.5, D47.6, D58.4, D58.5, D58.6, D69.4, D69.5, D69.6, D80.4, D80.5, D80.6, D91.4, D91.5, D91.6, D102.4, D102.5, D102.6, D113.4, D113.5, D113.6, D124.4, D124.5, D124.6, D135.4, D135.5, D135.6, D146.4, D146.5, D146.6, D157.4, D157.5, D157.6, D168.4, D168.5, D168.6, Q3.1
/3: D4.4, D4.5, D4.6, D15.4, D15.5, D15.6, D26.4, D26.5, D26.6, D37.4, D37.5, D37.6, D48.4, D48.5, D48.6, D59.4, D59.5, D59.6, D70.4, D70.5, D70.6, D81.4, D81.5, D81.6, D92.4, D92.5, D92.6, D103.4, D103.5, D103.6, D114.4, D114.5, D114.6, D125.4, D125.5, D125.6, D136.4, D136.5, D136.6, D147.4, D147.5, D147.6, D158.4, D158.5, D158.6, D169.4, D169.5, D169.6, Q4.1
/4: D5.4, D5.5, D5.6, D16.4, D16.5, D16.6, D27.4, D27.5, D27.6, D38.4, D38.5, D38.6, D49.4, D49.5, D49.6, D60.4, D60.5, D60.6, D71.4, D71.5, D71.6, D82.4, D82.5, D82.6, D93.4, D93.5, D93.6, D104.4, D104.5, D104.6, D115.4, D115.5, D115.6, D126.4, D126.5, D126.6, D137.4, D137.5, D137.6, D148.4, D148.5, D148.6, D159.4, D159.5, D159.6, D170.4, D170.5, D170.6, Q5.1
/5: D6.4, D6.5, D6.6, D17.4, D17.5, D17.6, D28.4, D28.5, D28.6, D39.4, D39.5, D39.6, D50.4, D50.5, D50.6, D61.4, D61.5, D61.6, D72.4, D72.5, D72.6, D83.4, D83.5, D83.6, D94.4, D94.5, D94.6, D105.4, D105.5, D105.6, D116.4, D116.5, D116.6, D127.4, D127.5, D127.6, D138.4, D138.5, D138.6, D149.4, D149.5, D149.6, D160.4, D160.5, D160.6, D171.4, D171.5, D171.6, Q6.1
/6: D7.4, D7.5, D7.6, D18.4, D18.5, D18.6, D29.4, D29.5, D29.6, D40.4, D40.5, D40.6, D51.4, D51.5, D51.6, D62.4, D62.5, D62.6, D73.4, D73.5, D73.6, D84.4, D84.5, D84.6, D95.4, D95.5, D95.6, D106.4, D106.5, D106.6, D117.4, D117.5, D117.6, D128.4, D128.5, D128.6, D139.4, D139.5, D139.6, D150.4, D150.5, D150.6, D161.4, D161.5, D161.6, D172.4, D172.5, D172.6, Q7.1
/7: D8.4, D8.5, D8.6, D19.4, D19.5, D19.6, D30.4, D30.5, D30.6, D41.4, D41.5, D41.6, D52.4, D52.5, D52.6, D63.4, D63.5, D63.6, D74.4, D74.5, D74.6, D85.4, D85.5, D85.6, D96.4, D96.5, D96.6, D107.4, D107.5, D107.6, D118.4, D118.5, D118.6, D129.4, D129.5, D129.6, D140.4, D140.5, D140.6, D151.4, D151.5, D151.6, D162.4, D162.5, D162.6, D173.4, D173.5, D173.6, Q8.1
/8: D9.4, D9.5, D9.6, D20.4, D20.5, D20.6, D31.4, D31.5, D31.6, D42.4, D42.5, D42.6, D53.4, D53.5, D53.6, D64.4, D64.5, D64.6, D75.4, D75.5, D75.6, D86.4, D86.5, D86.6, D97.4, D97.5, D97.6, D108.4, D108.5, D108.6, D119.4, D119.5, D119.6, D130.4, D130.5, D130.6, D141.4, D141.5, D141.6, D152.4, D152.5, D152.6, D163.4, D163.5, D163.6, D174.4, D174.5, D174.6, Q9.1
/9: D10.4, D10.5, D10.6, D21.4, D21.5, D21.6, D32.4, D32.5, D32.6, D43.4, D43.5, D43.6, D54.4, D54.5, D54.6, D65.4, D65.5, D65.6, D76.4, D76.5, D76.6, D87.4, D87.5, D87.6, D98.4, D98.5, D98.6, D109.4, D109.5, D109.6, D120.4, D120.5, D120.6, D131.4, D131.5, D131.6, D142.4, D142.5, D142.6, D153.4, D153.5, D153.6, D164.4, D164.5, D164.6, D175.4, D175.5, D175.6, Q10.1
/10: D11.4, D11.5, D11.6, D22.4, D22.5, D22.6, D33.4, D33.5, D33.6, D44.4, D44.5, D44.6, D55.4, D55.5, D55.6, D66.4, D66.5, D66.6, D77.4, D77.5, D77.6, D88.4, D88.5, D88.6, D99.4, D99.5, D99.6, D110.4, D110.5, D110.6, D121.4, D121.5, D121.6, D132.4, D132.5, D132.6, D143.4, D143.5, D143.6, D154.4, D154.5, D154.6, D165.4, D165.5, D165.6, D176.4, D176.5, D176.6, Q11.1
/B0: D1.3, D2.3, D3.3, D4.3, D5.3, D6.3, D7.3, D8.3, D9.3, D10.3, D11.3, Q14.3
/B1: D12.3, D13.3, D14.3, D15.3, D16.3, D17.3, D18.3, D19.3, D20.3, D21.3, D22.3, Q17.3
/B2: D23.3, D24.3, D25.3, D26.3, D27.3, D28.3, D29.3, D30.3, D31.3, D32.3, D33.3, Q20.3
/B3: D34.3, D35.3, D36.3, D37.3, D38.3, D39.3, D40.3, D41.3, D42.3, D43.3, D44.3, Q23.3
/B4: D45.3, D46.3, D47.3, D48.3, D49.3, D50.3, D51.3, D52.3, D53.3, D54.3, D55.3, Q26.3
/B5: D56.3, D57.3, D58.3, D59.3, D60.3, D61.3, D62.3, D63.3, D64.3, D65.3, D66.3, Q29.3
/B6: D67.3, D68.3, D69.3, D70.3, D71.3, D72.3, D73.3, D74.3, D75.3, D76.3, D77.3, Q32.3
/B7: D78.3, D79.3, D80.3, D81.3, D82.3, D83.3, D84.3, D85.3, D86.3, D87.3, D88.3, Q35.3
/B8: D89.3, D90.3, D91.3, D92.3, D93.3, D94.3, D95.3, D96.3, D97.3, D98.3, D99.3, Q38.3
/B9: D100.3, D101.3, D102.3, D103.3, D104.3, D105.3, D106.3, D107.3, D108.3, D109.3, D110.3, Q41.3
/B10: D111.3, D112.3, D113.3, D114.3, D115.3, D116.3, D117.3, D118.3, D119.3, D120.3, D121.3, Q44.3
/B11: D122.3, D123.3, D124.3, D125.3, D126.3, D127.3, D128.3, D129.3, D130.3, D131.3, D132.3, Q47.3
/B12: D133.3, D134.3, D135.3, D136.3, D137.3, D138.3, D139.3, D140.3, D141.3, D142.3, D143.3, Q50.3
/B13: D144.3, D145.3, D146.3, D147.3, D148.3, D149.3, D150.3, D151.3, D152.3, D153.3, D154.3, Q53.3
/B14: D155.3, D156.3, D157.3, D158.3, D159.3, D160.3, D161.3, D162.3, D163.3, D164.3, D165.3, Q56.3
/B15: D166.3, D167.3, D168.3, D169.3, D170.3, D171.3, D172.3, D173.3, D174.3, D175.3, D176.3, Q59.3
/D7_OUT: U8.7, U9.2
/DCLK: J1.13, U1.1, U2.1, U3.1, U4.1, U5.1, U6.1, U7.1, U8.1, U9.1, U10.1, U11.1, U12.1, U13.1, U14.1, U15.1, U16.1
/DIN: J1.12, U1.2
/G0: D1.2, D2.2, D3.2, D4.2, D5.2, D6.2, D7.2, D8.2, D9.2, D10.2, D11.2, Q13.3
/G1: D12.2, D13.2, D14.2, D15.2, D16.2, D17.2, D18.2, D19.2, D20.2, D21.2, D22.2, Q16.3
/G2: D23.2, D24.2, D25.2, D26.2, D27.2, D28.2, D29.2, D30.2, D31.2, D32.2, D33.2, Q19.3
/G3: D34.2, D35.2, D36.2, D37.2, D38.2, D39.2, D40.2, D41.2, D42.2, D43.2, D44.2, Q22.3
/G4: D45.2, D46.2, D47.2, D48.2, D49.2, D50.2, D51.2, D52.2, D53.2, D54.2, D55.2, Q25.3
/G5: D56.2, D57.2, D58.2, D59.2, D60.2, D61.2, D62.2, D63.2, D64.2, D65.2, D66.2, Q28.3
/G6: D67.2, D68.2, D69.2, D70.2, D71.2, D72.2, D73.2, D74.2, D75.2, D76.2, D77.2, Q31.3
/G7: D78.2, D79.2, D80.2, D81.2, D82.2, D83.2, D84.2, D85.2, D86.2, D87.2, D88.2, Q34.3
/G8: D89.2, D90.2, D91.2, D92.2, D93.2, D94.2, D95.2, D96.2, D97.2, D98.2, D99.2, Q37.3
/G9: D100.2, D101.2, D102.2, D103.2, D104.2, D105.2, D106.2, D107.2, D108.2, D109.2, D110.2, Q40.3
/G10: D111.2, D112.2, D113.2, D114.2, D115.2, D116.2, D117.2, D118.2, D119.2, D120.2, D121.2, Q43.3
/G11: D122.2, D123.2, D124.2, D125.2, D126.2, D127.2, D128.2, D129.2, D130.2, D131.2, D132.2, Q46.3
/G12: D133.2, D134.2, D135.2, D136.2, D137.2, D138.2, D139.2, D140.2, D141.2, D142.2, D143.2, Q49.3
/G13: D144.2, D145.2, D146.2, D147.2, D148.2, D149.2, D150.2, D151.2, D152.2, D153.2, D154.2, Q52.3
/G14: D155.2, D156.2, D157.2, D158.2, D159.2, D160.2, D161.2, D162.2, D163.2, D164.2, D165.2, Q55.3
/G15: D166.2, D167.2, D168.2, D169.2, D170.2, D171.2, D172.2, D173.2, D174.2, D175.2, D176.2, Q58.3
/PWM Controller/B_PWM: R3.1, U1.3
/PWM Controller/G_PWM: R2.1, U1.6
/PWM Controller/R_PWM: R1.1, U1.5
/R0: D1.1, D2.1, D3.1, D4.1, D5.1, D6.1, D7.1, D8.1, D9.1, D10.1, D11.1, Q12.3
/R1: D12.1, D13.1, D14.1, D15.1, D16.1, D17.1, D18.1, D19.1, D20.1, D21.1, D22.1, Q15.3
/R2: D23.1, D24.1, D25.1, D26.1, D27.1, D28.1, D29.1, D30.1, D31.1, D32.1, D33.1, Q18.3
/R3: D34.1, D35.1, D36.1, D37.1, D38.1, D39.1, D40.1, D41.1, D42.1, D43.1, D44.1, Q21.3
/R4: D45.1, D46.1, D47.1, D48.1, D49.1, D50.1, D51.1, D52.1, D53.1, D54.1, D55.1, Q24.3
/R5: D56.1, D57.1, D58.1, D59.1, D60.1, D61.1, D62.1, D63.1, D64.1, D65.1, D66.1, Q27.3
/R6: D67.1, D68.1, D69.1, D70.1, D71.1, D72.1, D73.1, D74.1, D75.1, D76.1, D77.1, Q30.3
/R7: D78.1, D79.1, D80.1, D81.1, D82.1, D83.1, D84.1, D85.1, D86.1, D87.1, D88.1, Q33.3
/R8: D89.1, D90.1, D91.1, D92.1, D93.1, D94.1, D95.1, D96.1, D97.1, D98.1, D99.1, Q36.3
/R9: D100.1, D101.1, D102.1, D103.1, D104.1, D105.1, D106.1, D107.1, D108.1, D109.1, D110.1, Q39.3
/R10: D111.1, D112.1, D113.1, D114.1, D115.1, D116.1, D117.1, D118.1, D119.1, D120.1, D121.1, Q42.3
/R11: D122.1, D123.1, D124.1, D125.1, D126.1, D127.1, D128.1, D129.1, D130.1, D131.1, D132.1, Q45.3
/R12: D133.1, D134.1, D135.1, D136.1, D137.1, D138.1, D139.1, D140.1, D141.1, D142.1, D143.1, Q48.3
/R13: D144.1, D145.1, D146.1, D147.1, D148.1, D149.1, D150.1, D151.1, D152.1, D153.1, D154.1, Q51.3
/R14: D155.1, D156.1, D157.1, D158.1, D159.1, D160.1, D161.1, D162.1, D163.1, D164.1, D165.1, Q54.3
/R15: D166.1, D167.1, D168.1, D169.1, D170.1, D171.1, D172.1, D173.1, D174.1, D175.1, D176.1, Q57.3
/ROW0: J1.1, Q1.3
/ROW1: J1.2, Q2.3
/ROW2: J1.3, Q3.3
/ROW3: J1.4, Q4.3
/ROW4: J1.5, Q5.3
/ROW5: J1.6, Q6.3
/ROW6: J1.7, Q7.3
/ROW7: J1.8, Q8.3
/ROW8: J1.9, Q9.3
/ROW9: J1.10, Q10.3
/ROW10: J1.11, Q11.3
/sheet5C02A49B/B_PWM: R39.1, U7.3
/sheet5C02A49B/DIN: U6.7, U7.2
/sheet5C02A49B/G_PWM: R38.1, U7.6
/sheet5C02A49B/R_PWM: R37.1, U7.5
/sheet5C02A49D/B_PWM: R45.1, U8.3
/sheet5C02A49D/DIN: U7.7, U8.2
/sheet5C02A49D/G_PWM: R44.1, U8.6
/sheet5C02A49D/R_PWM: R43.1, U8.5
/sheet5C02A497/B_PWM: R27.1, U5.3
/sheet5C02A497/DIN: U4.7, U5.2
/sheet5C02A497/G_PWM: R26.1, U5.6
/sheet5C02A497/R_PWM: R25.1, U5.5
/sheet5C02A499/B_PWM: R33.1, U6.3
/sheet5C02A499/DIN: U5.7, U6.2
/sheet5C02A499/G_PWM: R32.1, U6.6
/sheet5C02A499/R_PWM: R31.1, U6.5
/sheet5C02E5C7/B_PWM: R51.1, U9.3
/sheet5C02E5C7/G_PWM: R50.1, U9.6
/sheet5C02E5C7/R_PWM: R49.1, U9.5
/sheet5C02E5C9/B_PWM: R57.1, U10.3
/sheet5C02E5C9/DIN: U9.7, U10.2
/sheet5C02E5C9/G_PWM: R56.1, U10.6
/sheet5C02E5C9/R_PWM: R55.1, U10.5
/sheet5C02E5CB/B_PWM: R63.1, U11.3
/sheet5C02E5CB/DIN: U10.7, U11.2
/sheet5C02E5CB/G_PWM: R62.1, U11.6
/sheet5C02E5CB/R_PWM: R61.1, U11.5
/sheet5C7E23D8/B_PWM: R75.1, U13.3
/sheet5C7E23D8/DIN: U12.7, U13.2
/sheet5C7E23D8/G_PWM: R74.1, U13.6
/sheet5C7E23D8/R_PWM: R73.1, U13.5
/sheet5C7E23D9/B_PWM: R81.1, U14.3
/sheet5C7E23D9/DIN: U13.7, U14.2
/sheet5C7E23D9/G_PWM: R80.1, U14.6
/sheet5C7E23D9/R_PWM: R79.1, U14.5
/sheet5C026B32/B_PWM: R9.1, U2.3
/sheet5C026B32/DIN: U1.7, U2.2
/sheet5C026B32/G_PWM: R8.1, U2.6
/sheet5C026B32/R_PWM: R7.1, U2.5
/sheet5C87E357/B_PWM: R93.1, U16.3
/sheet5C87E357/DIN: U15.7, U16.2
/sheet5C87E357/G_PWM: R92.1, U16.6
/sheet5C87E357/R_PWM: R91.1, U16.5
/sheet5C156C5A/B_PWM: R69.1, U12.3
/sheet5C156C5A/DIN: U11.7, U12.2
/sheet5C156C5A/G_PWM: R68.1, U12.6
/sheet5C156C5A/R_PWM: R67.1, U12.5
/sheet5C853AF2/B_PWM: R87.1, U15.3
/sheet5C853AF2/DIN: U14.7, U15.2
/sheet5C853AF2/G_PWM: R86.1, U15.6
/sheet5C853AF2/R_PWM: R85.1, U15.5
/sheet5C02892F/B_PWM: R15.1, U3.3
/sheet5C02892F/DIN: U2.7, U3.2
/sheet5C02892F/G_PWM: R14.1, U3.6
/sheet5C02892F/R_PWM: R13.1, U3.5
/sheet5C028931/B_PWM: R21.1, U4.3
/sheet5C028931/DIN: U3.7, U4.2
/sheet5C028931/G_PWM: R20.1, U4.6
/sheet5C028931/R_PWM: R19.1, U4.5
GND: R4.2, R5.2, R6.2, R10.2, R11.2, R12.2, R16.2, R17.2, R18.2, R22.2, R23.2, R24.2, R28.2, R29.2, R30.2, R34.2, R35.2, R36.2, R40.2, R41.2, R42.2, R46.2, R47.2, R48.2, R52.2, R53.2, R54.2, R58.2, R59.2, R60.2, R64.2, R65.2, R66.2, R70.2, R71.2, R72.2, R76.2, R77.2, R78.2, R82.2, R83.2, R84.2, R88.2, R89.2, R90.2, R94.2, R95.2, R96.2, U1.4, U2.4, U3.4, U4.4, U5.4, U6.4, U7.4, U8.4, U9.4, U10.4, U11.4, U12.4, U13.4, U14.4, U15.4, U16.4
unnamed: Q12.1, R4.1
unnamed: Q12.2, R1.2
unnamed: Q13.1, R5.1
unnamed: Q13.2, R2.2
unnamed: Q14.1, R6.1
unnamed: Q14.2, R3.2
unnamed: Q15.1, R10.1
unnamed: Q15.2, R7.2
unnamed: Q16.1, R11.1
unnamed: Q16.2, R8.2
unnamed: Q17.1, R12.1
unnamed: Q17.2, R9.2
unnamed: Q18.1, R16.1
unnamed: Q18.2, R13.2
unnamed: Q19.1, R17.1
unnamed: Q19.2, R14.2
unnamed: Q20.1, R18.1
unnamed: Q20.2, R15.2
unnamed: Q21.1, R22.1
unnamed: Q21.2, R19.2
unnamed: Q22.1, R23.1
unnamed: Q22.2, R20.2
unnamed: Q23.1, R24.1
unnamed: Q23.2, R21.2
unnamed: Q24.1, R28.1
unnamed: Q24.2, R25.2
unnamed: Q25.1, R29.1
unnamed: Q25.2, R26.2
unnamed: Q26.1, R30.1
unnamed: Q26.2, R27.2
unnamed: Q27.1, R34.1
unnamed: Q27.2, R31.2
unnamed: Q28.1, R35.1
unnamed: Q28.2, R32.2
unnamed: Q29.1, R36.1
unnamed: Q29.2, R33.2
unnamed: Q30.1, R40.1
unnamed: Q30.2, R37.2
unnamed: Q31.1, R41.1
unnamed: Q31.2, R38.2
unnamed: Q32.1, R42.1
unnamed: Q32.2, R39.2
unnamed: Q33.1, R46.1
unnamed: Q33.2, R43.2
unnamed: Q34.1, R47.1
unnamed: Q34.2, R44.2
unnamed: Q35.1, R48.1
unnamed: Q35.2, R45.2
unnamed: Q36.1, R52.1
unnamed: Q36.2, R49.2
unnamed: Q37.1, R53.1
unnamed: Q37.2, R50.2
unnamed: Q38.1, R54.1
unnamed: Q38.2, R51.2
unnamed: Q39.1, R58.1
unnamed: Q39.2, R55.2
unnamed: Q40.1, R59.1
unnamed: Q40.2, R56.2
unnamed: Q41.1, R60.1
unnamed: Q41.2, R57.2
unnamed: Q42.1, R64.1
unnamed: Q42.2, R61.2
unnamed: Q43.1, R65.1
unnamed: Q43.2, R62.2
unnamed: Q44.1, R66.1
unnamed: Q44.2, R63.2
unnamed: Q45.1, R70.1
unnamed: Q45.2, R67.2
unnamed: Q46.1, R71.1
unnamed: Q46.2, R68.2
unnamed: Q47.1, R72.1
unnamed: Q47.2, R69.2
unnamed: Q48.1, R76.1
unnamed: Q48.2, R73.2
unnamed: Q49.1, R77.1
unnamed: Q49.2, R74.2
unnamed: Q50.1, R78.1
unnamed: Q50.2, R75.2
unnamed: Q51.1, R82.1
unnamed: Q51.2, R79.2
unnamed: Q52.1, R83.1
unnamed: Q52.2, R80.2
unnamed: Q53.1, R84.1
unnamed: Q53.2, R81.2
unnamed: Q54.1, R88.1
unnamed: Q54.2, R85.2
unnamed: Q55.1, R89.1
unnamed: Q55.2, R86.2
unnamed: Q56.1, R90.1
unnamed: Q56.2, R87.2
unnamed: Q57.1, R94.1
unnamed: Q57.2, R91.2
unnamed: Q58.1, R95.1
unnamed: Q58.2, R92.2
unnamed: Q59.1, R96.1
unnamed: Q59.2, R93.2
