ryanjsims/word_clock/(commit log)

2018-09-06 Added to git
    [led_grid.fzz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]
2018-10-16 Added all files
    [led_grid.fzz]
2018-10-16 Added everything for real
    [clock_face.dxf, clock_model.FCStd]
2018-11-28 Added LED grid kicad files
    [LED_column.sch, LED_grid.kicad_pcb, LED_grid.sch, PWM_controller.sch]
2018-12-05 Added additional led grid without controllers
    [LED_column.sch, LED_grid.kicad_pcb, LED_grid.sch, LED_grid_no_controllers.kicad_pcb, LED_grid_no_controllers.sch, PWM_controller.sch]
2018-12-05 Added led grid controllers files
    [LED_grid_controllers.kicad_pcb, LED_grid_controllers.sch]
2018-12-05 Added extra columns to grid along with 5V pin to connectors
    [LED_column.sch, LED_grid_no_controllers.sch]
2018-12-21 Added 3 updated designs and partslist for revision 1 and 2 of the led grid
    [LED_grid_ESP32.kicad_pcb, LED_grid_ESP32.sch, LED_grid_TLC5946.kicad_pcb, LED_grid_TLC5946.sch, LED_grid_controllers.csv, LED_grid_controllers.kicad_pcb, LED_grid_controllers.sch, LED_grid_for_TLC5946.kicad_pcb]
